jalinei/OWNVERTER/KiCAD_files/Feeder.kicad_sch

## KiCad design KiCAD_files/Feeder.kicad_sch (2024-07-15)

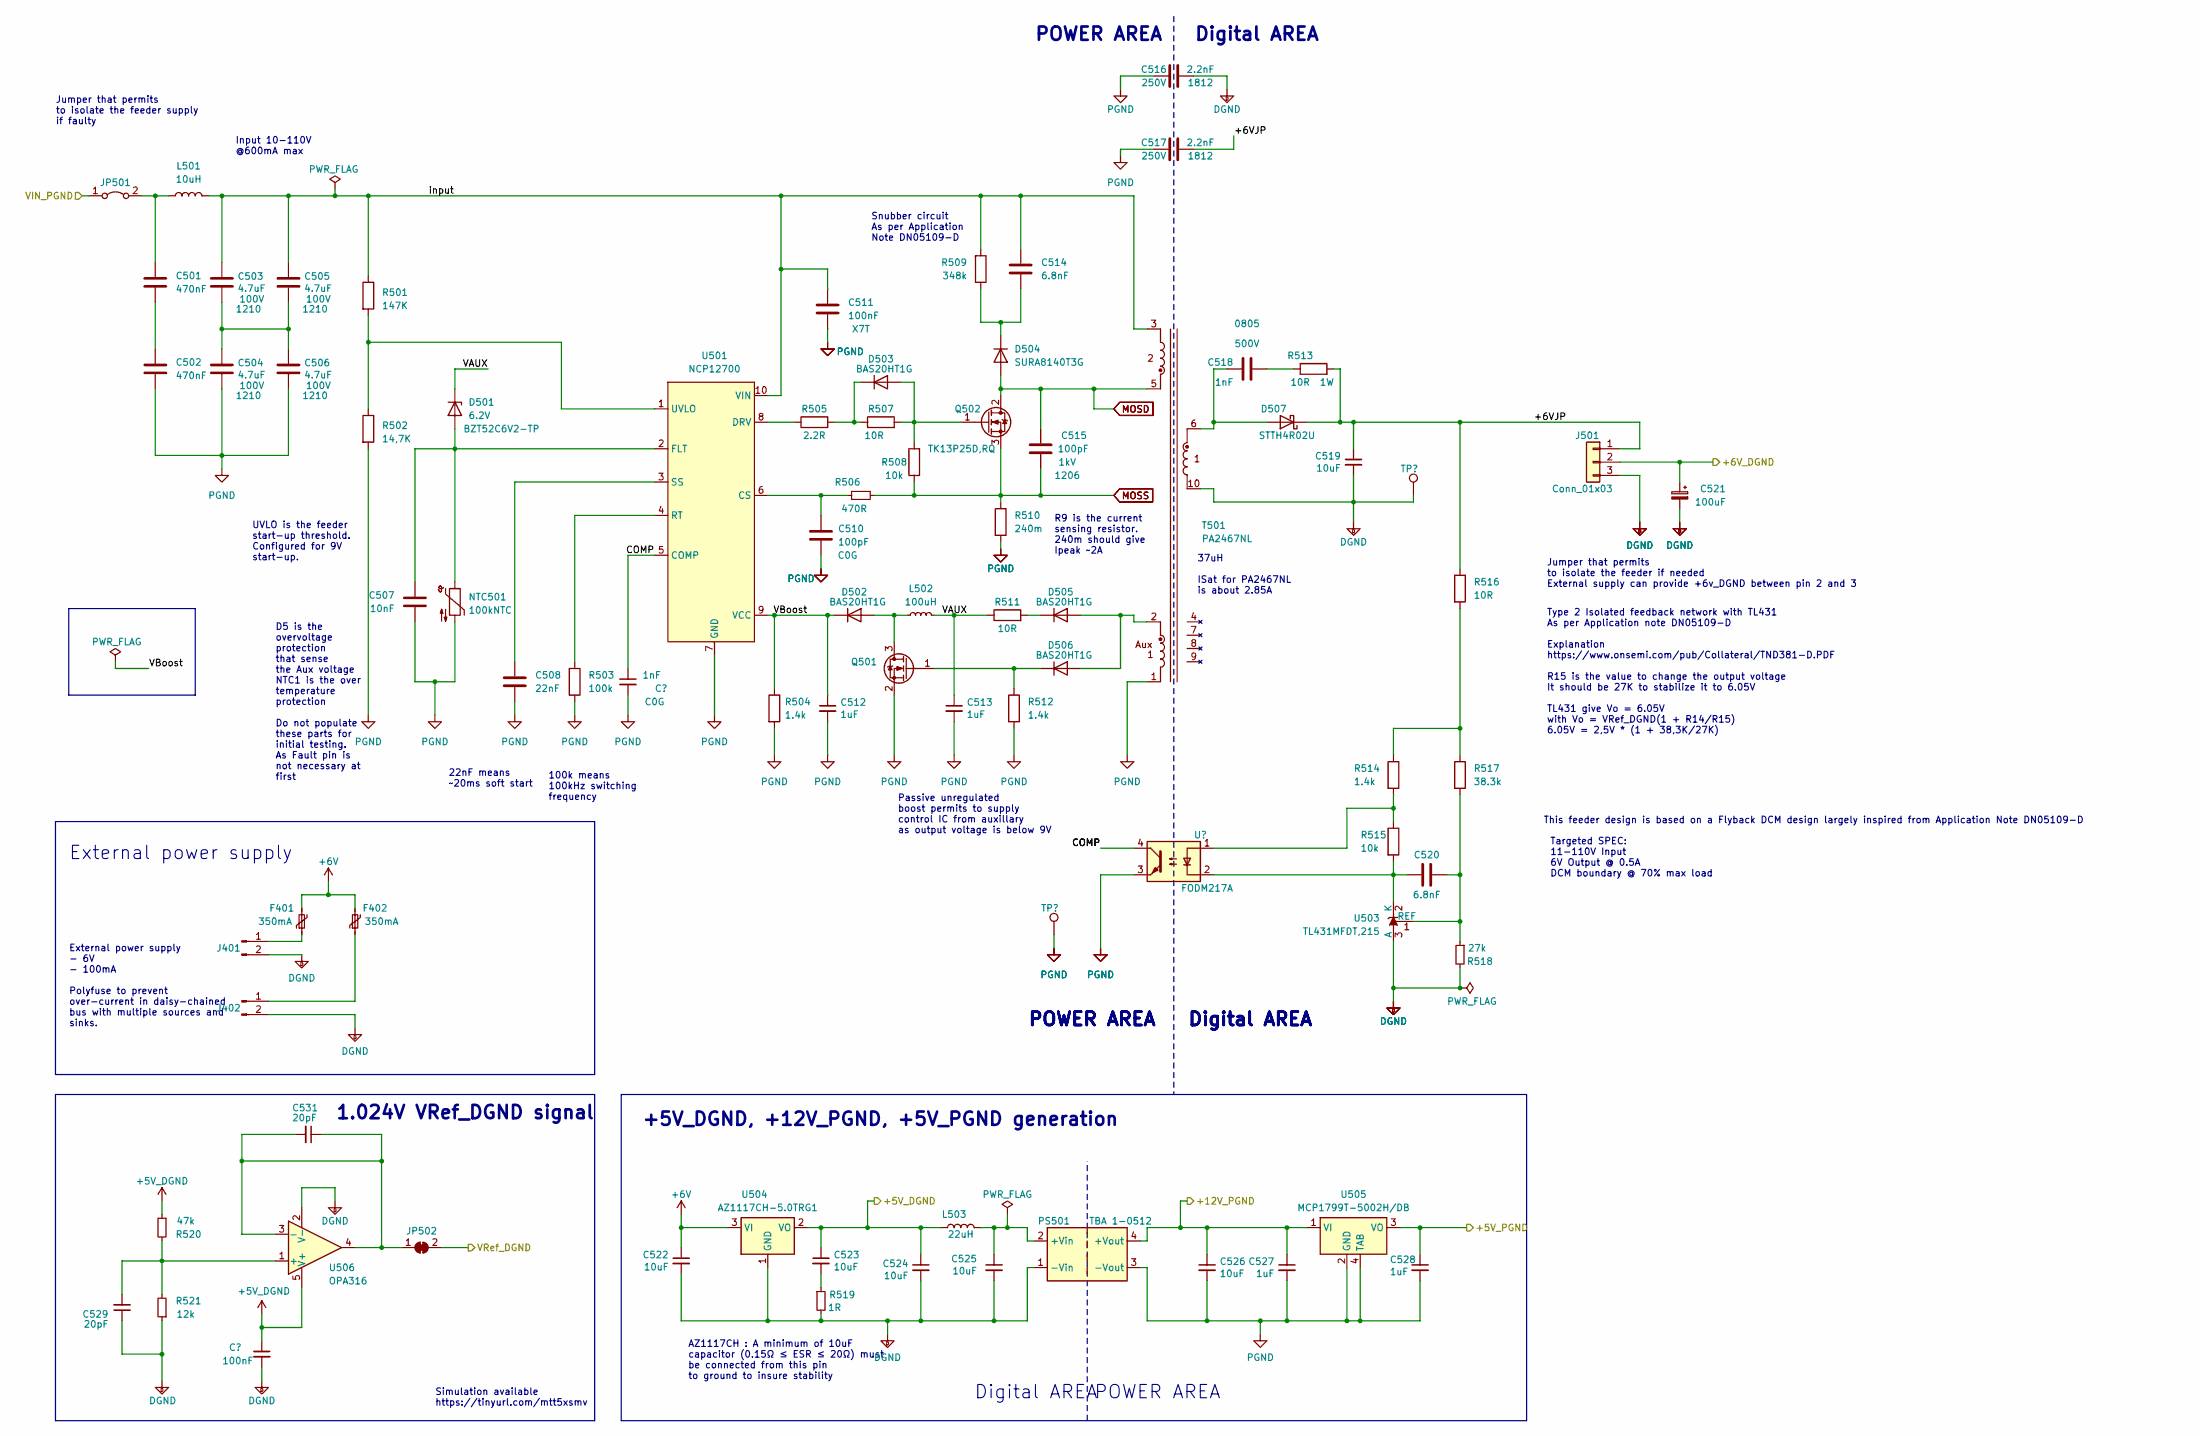
[picture p1: schematic Feeder.kicad_sch]

Parts:
C501, C502: 470nF; C_0805_2012Metric
C503, C504, C505, C506: 4.7uF; C_1210_3225Metric; Voltage 100V
C507: 10nF; C_0805_2012Metric
C508: 22nF; C_0805_2012Metric
C509: 1nF; C_0805_2012Metric; Voltage 100V
C510: 100pF; C_0805_2012Metric
C511: 100nF; C_0805_2012Metric
C512, C513, C527, C528: 1uF; C_0805_2012Metric
C514, C520: 6.8nF; C_0805_2012Metric
C515: 100pF; C_1206_3216Metric; Voltage 1kV
C516, C517: 2.2nF; C_1812_4532Metric; Voltage 250V
C518: 1nF; C_0805_2012Metric; Voltage 500V
C519, C522, C523: 10uF; C_1210_3225Metric; Voltage 50V
C521: 100uF; CP_Elec_6.3x7.7
C524, C525, C526: 10uF; C_1210_3225Metric; Voltage 25V
C529, C531: 20pF; C_0805_2012Metric
C530: 100nF; C_0805_2012Metric; Voltage 50V
D501: 6.2V; D_SOD-123
D502, D503, D505, D506: BAS20HT1G; D_SOD-323_HandSoldering
D504: SURA8140T3G; D_SMA
D507: STTH4R02U; D_SMB
F401, F402: 350mA; Fuse_1210_3225Metric
J401, J402: Conn_01x02_Male; JST_EH_B2B-EH-A_1x02_P2.50mm_Vertical
J501: Conn_01x03; PinHeader_1x03_P2.54mm_Vertical
JP501: Jumper_2_Bridged; SolderJumper-2_P1.3mm_Bridged2Bar_Pad1.0x1.5mm
JP502: SolderJumper_2_Open; SolderJumper-2_P1.3mm_Bridged_Pad1.0x1.5mm
L501: 10uH; L_1210_3225Metric
L502: 100uH; L_0805_2012Metric
L503: 22uH; L_1210_3225Metric
NTC501: 100kNTC; R_0805_2012Metric
PS501: TBA 1-0512; Converter_DCDC_Murata_MEE1SxxxxSC_THT
Q501: 60V N channel; SOT-23_copy
Q502: TK13P25D,RQ; TO-252-2
R501: 147K; R_0805_2012Metric
R502: 14,7K; R_0805_2012Metric
R503: 100k; R_0805_2012Metric
R504, R512, R514: 1.4k; R_0805_2012Metric
R505: 2.2R; R_0805_2012Metric
R506: 470R; R_0805_2012Metric
R507, R511, R516: 10R; R_0805_2012Metric
R508, R515: 10k; R_0805_2012Metric
R509: 348k; R_0805_2012Metric
R510: 240m; R_1210_3225Metric
R513: 10R; R_2010_5025Metric
R517: 38.3k; R_0805_2012Metric
R518: 27k; R_0805_2012Metric
R519: 1R; R_0805_2012Metric
R520: 47k; R_0805_2012Metric
R521: 12k; R_0805_2012Metric
T501: PA2467NL
TP501, TP502: TestPoint; TestPoint_THTPad_D1.5mm_Drill0.7mm
U501: NCP12700; MSOP-10_3x3mm_P0.5mm
U502: FODM217A; SO-4_4.4x2.3mm_P1.27mm
U503: TL431MFDT,215; SOT-23
U504: AZ1117CH-5.0TRG1; SOT-223-3_TabPin2
U505: MCP1799T-5002H/DB; SOT-223
U506: OPA316; SOT-353_SC-70-5_Handsoldering

Connections:
+5V_DGND: C523.1, C524.1, C530.1, L503.1, R520.1, U504.2 (VO), U506.5 (V+)
+5V_PGND: C528.1, U505.3 (VO)
+6V: C522.1, F401.2, F402.2, U504.3 (VI)
+6VJP: C517.2, C519.1, D507.1 (K), J501.1, R513.2, R516.1
+6V_DGND: C521.1, J501.2
+12V_PGND: C526.1, C527.1, PS501.4 (+Vout), U505.1 (VI)
COMP: C509.1, U501.5 (COMP), U502.4
DGND: C516.2, C519.2, C521.2, C522.2, C524.2, C525.2, C529.1, C530.2, J401.2, J402.2, J501.3, PS501.1 (-Vin), R518.2, R519.2, R521.1, T501.10, TP502.1, U503.3 (A), U504.1 (GND), U506.2 (V-)
MOSD: C515.1, D504.2 (A), Q502.2 (D), T501.5
MOSS: C515.2, Q502.3 (S), R506.2, R508.1, R510.1
unnamed: C501.1, JP501.2 (B), L501.1
unnamed: C501.2, C502.1
unnamed: C503.2, C504.1, C505.2, C506.1
unnamed: C507.2, D501.2 (A), NTC501.1, U501.2 (FLT)
unnamed: C508.1, U501.3 (SS)
unnamed: C510.1, R506.1, U501.6 (CS)
unnamed: C514.2, D504.1 (K), R509.1
unnamed: C518.1, D507.2 (A), T501.6
unnamed: C518.2, R513.1
unnamed: C520.1, R515.2, U502.2, U503.2 (K)
unnamed: C520.2, R517.2, R518.1, U503.1 (REF)
unnamed: C523.2, R519.1
unnamed: C525.1, L503.2, PS501.2 (+Vin)
unnamed: C529.2, R520.2, R521.2, U506.1 (+)
unnamed: C531.1, C531.2, JP502.1 (A), U506.3 (-), U506.4
unnamed: D502.2 (A), L502.1, Q501.3 (D)
unnamed: D503.1 (K), R505.2, R507.1
unnamed: D503.2 (A), Q502.1 (G), R507.2, R508.2
unnamed: D505.1 (K), R511.2
unnamed: D505.2 (A), D506.2 (A), T501.2
unnamed: D506.1 (K), Q501.1 (G), R512.1
unnamed: F401.1, J401.1
unnamed: F402.1, J402.1
unnamed: R501.2, R502.1, U501.1 (UVLO)
unnamed: R503.1, U501.4 (RT)
unnamed: R505.1, U501.8 (DRV)
unnamed: R514.1, R516.2, R517.1
unnamed: R514.2, R515.1, U502.1
PGND: C502.2, C504.2, C506.2, C507.1, C508.2, C509.2, C510.2, C511.2, C512.2, C513.2, C516.1, C517.1, C526.2, C527.2, C528.2, NTC501.2, PS501.3 (-Vout), Q501.2 (S), R502.2, R503.2, R504.2, R510.2, R512.2, T501.1, TP501.1, U501.7 (GND), U502.3, U505.2 (GND), U505.4 (TAB)
VAUX: C513.1, D501.1 (K), L502.2, R511.1
VBoost: C512.1, D502.1 (K), R504.1, U501.9 (VCC)
VIN_PGND: JP501.1 (A)
VRef_DGND: JP502.2 (B)
input: C503.1, C505.1, C511.1, C514.1, L501.2, R501.1, R509.2, T501.3, U501.10 (VIN)

Notes on the sheet:
Snubber circuit As per Application Note DN05109-D
Input 10-110V @600mA max
R9 is the current sensing resistor. 240m should give Ipeak ~2A
POWER AREA
Digital AREA
Jumper that permits to isolate the feeder if needed External supply can provide +6v_DGND between pin 2 and 3
Targeted SPEC: 11-110V Input 6V Output @ 0.5A DCM boundary @ 70% max load
UVLO is the feeder start-up threshold. Configured for 9V start-up.
AZ1117CH : A minimum of 10uF capacitor (0.15Ω ≤ ESR ≤ 20Ω) must be connected from this pin to ground to insure stability
D5 is the overvoltage protection that sense the Aux voltage NTC1 is the over temperature protection Do not populate these parts for initial testing. As Fault pin is not necessary at first
External power supply - 6V - 100mA Polyfuse to prevent over-current in daisy-chained bus with multiple sources and sinks.
Passive unregulated boost permits to supply control IC from auxillary as output voltage is below 9V
Jumper that permits to isolate the feeder supply if faulty
This feeder design is based on a Flyback DCM design largely inspired from Application Note DN05109-D
100k means 100kHz switching frequency
37uH ISat for PA2467NL is about 2.85A
External power supply
1.024V VRef_DGND signal
22nF means ~20ms soft start
Simulation available https://tinyurl.com/mtt5xsmv
+5V_DGND, +12V_PGND, +5V_PGND generation
Type 2 Isolated feedback network with TL431 As per Application note DN05109-D Explanation https://www.onsemi.com/pub/Collateral/TND381-D.PDF R15 is the value to change the output voltage It should be 27K to stabilize it to 6.05V TL431 give Vo = 6.05V with Vo = VRef_DGND(1 + R14/R15) 6.05V = 2,5V * 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
