jalinei/OWNVERTER/KiCAD_files/Hall_Sensor.kicad_sch

## KiCad design KiCAD_files/Hall_Sensor.kicad_sch (2024-07-15)

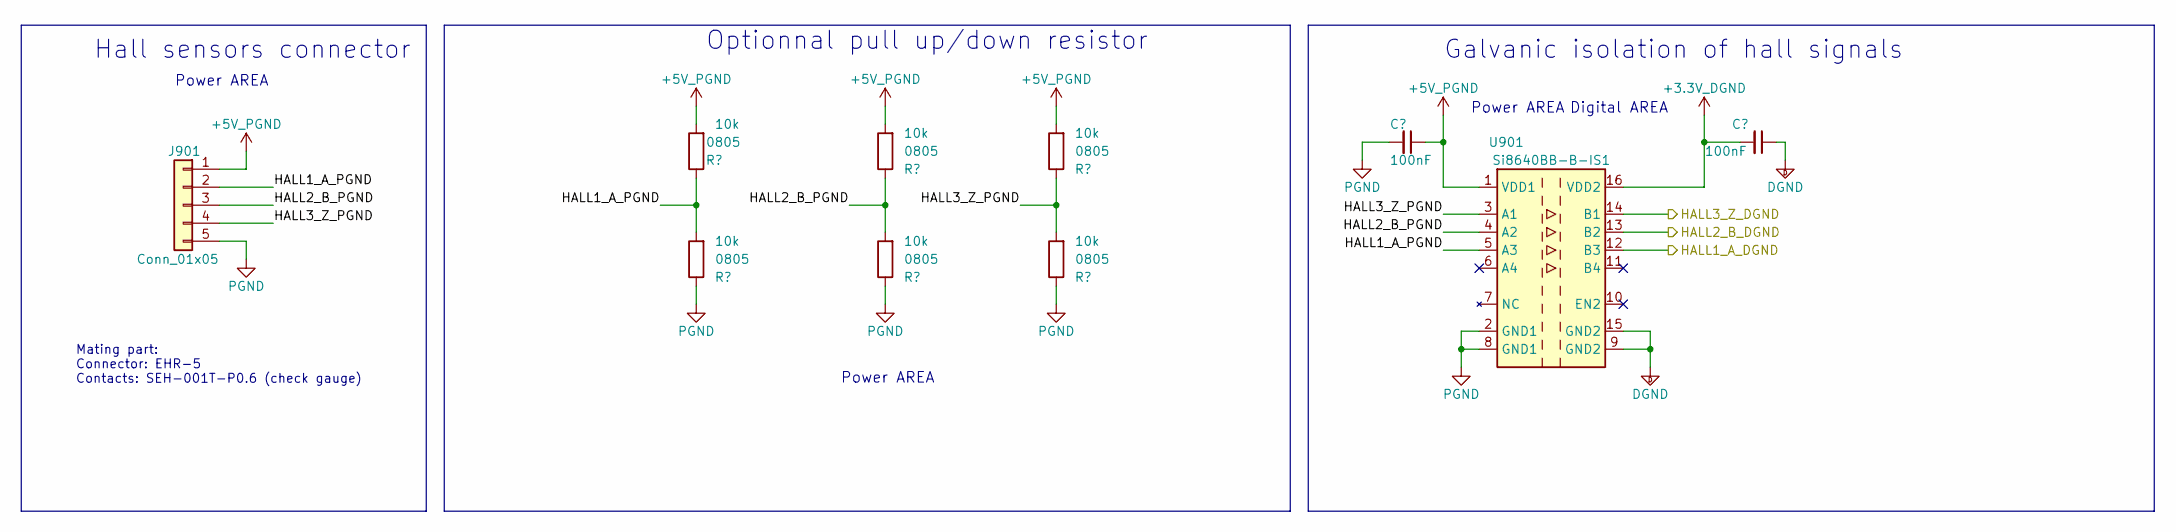
[picture p2: schematic Hall_Sensor.kicad_sch]

Parts:
C901, C902: 100nF; C_0805_2012Metric; Voltage 50V
J901: Conn_01x05; JST_EH_B5B-EH-A_1x05_P2.50mm_Vertical
R901, R902, R903, R904, R905, R906: 10k; R_0805_2012Metric
U901: Si8640BB-B-IS1; SOIC-16_3.9x9.9mm_P1.27mm

Connections:
+3.3V_DGND: C902.2, U901.16 (VDD2)
+5V_PGND: C901.1, J901.1, R901.2, R903.2, R905.2, U901.1 (VDD1)
DGND: C902.1, U901.9 (GND2), U901.15 (GND2)
HALL1_A_DGND: U901.12 (B3)
HALL1_A_PGND: J901.2, R901.1, R902.2, U901.5 (A3)
HALL2_B_DGND: U901.13 (B2)
HALL2_B_PGND: J901.3, R903.1, R904.2, U901.4 (A2)
HALL3_Z_DGND: U901.14 (B1)
HALL3_Z_PGND: J901.4, R905.1, R906.2, U901.3 (A1)
PGND: C901.2, J901.5, R902.1, R904.1, R906.1, U901.2 (GND1), U901.8 (GND1)

Notes on the sheet:
Hall sensors connector
Galvanic isolation of hall signals
Digital AREA
Power AREA
Optionnal pull up/down resistor
Mating part: Connector: EHR-5 Contacts: SEH-001T-P0.6 (check gauge)
