jalinei/OWNVERTER/KiCAD_files/High_side.kicad_sch

## KiCad design KiCAD_files/High_side.kicad_sch (2024-07-15)

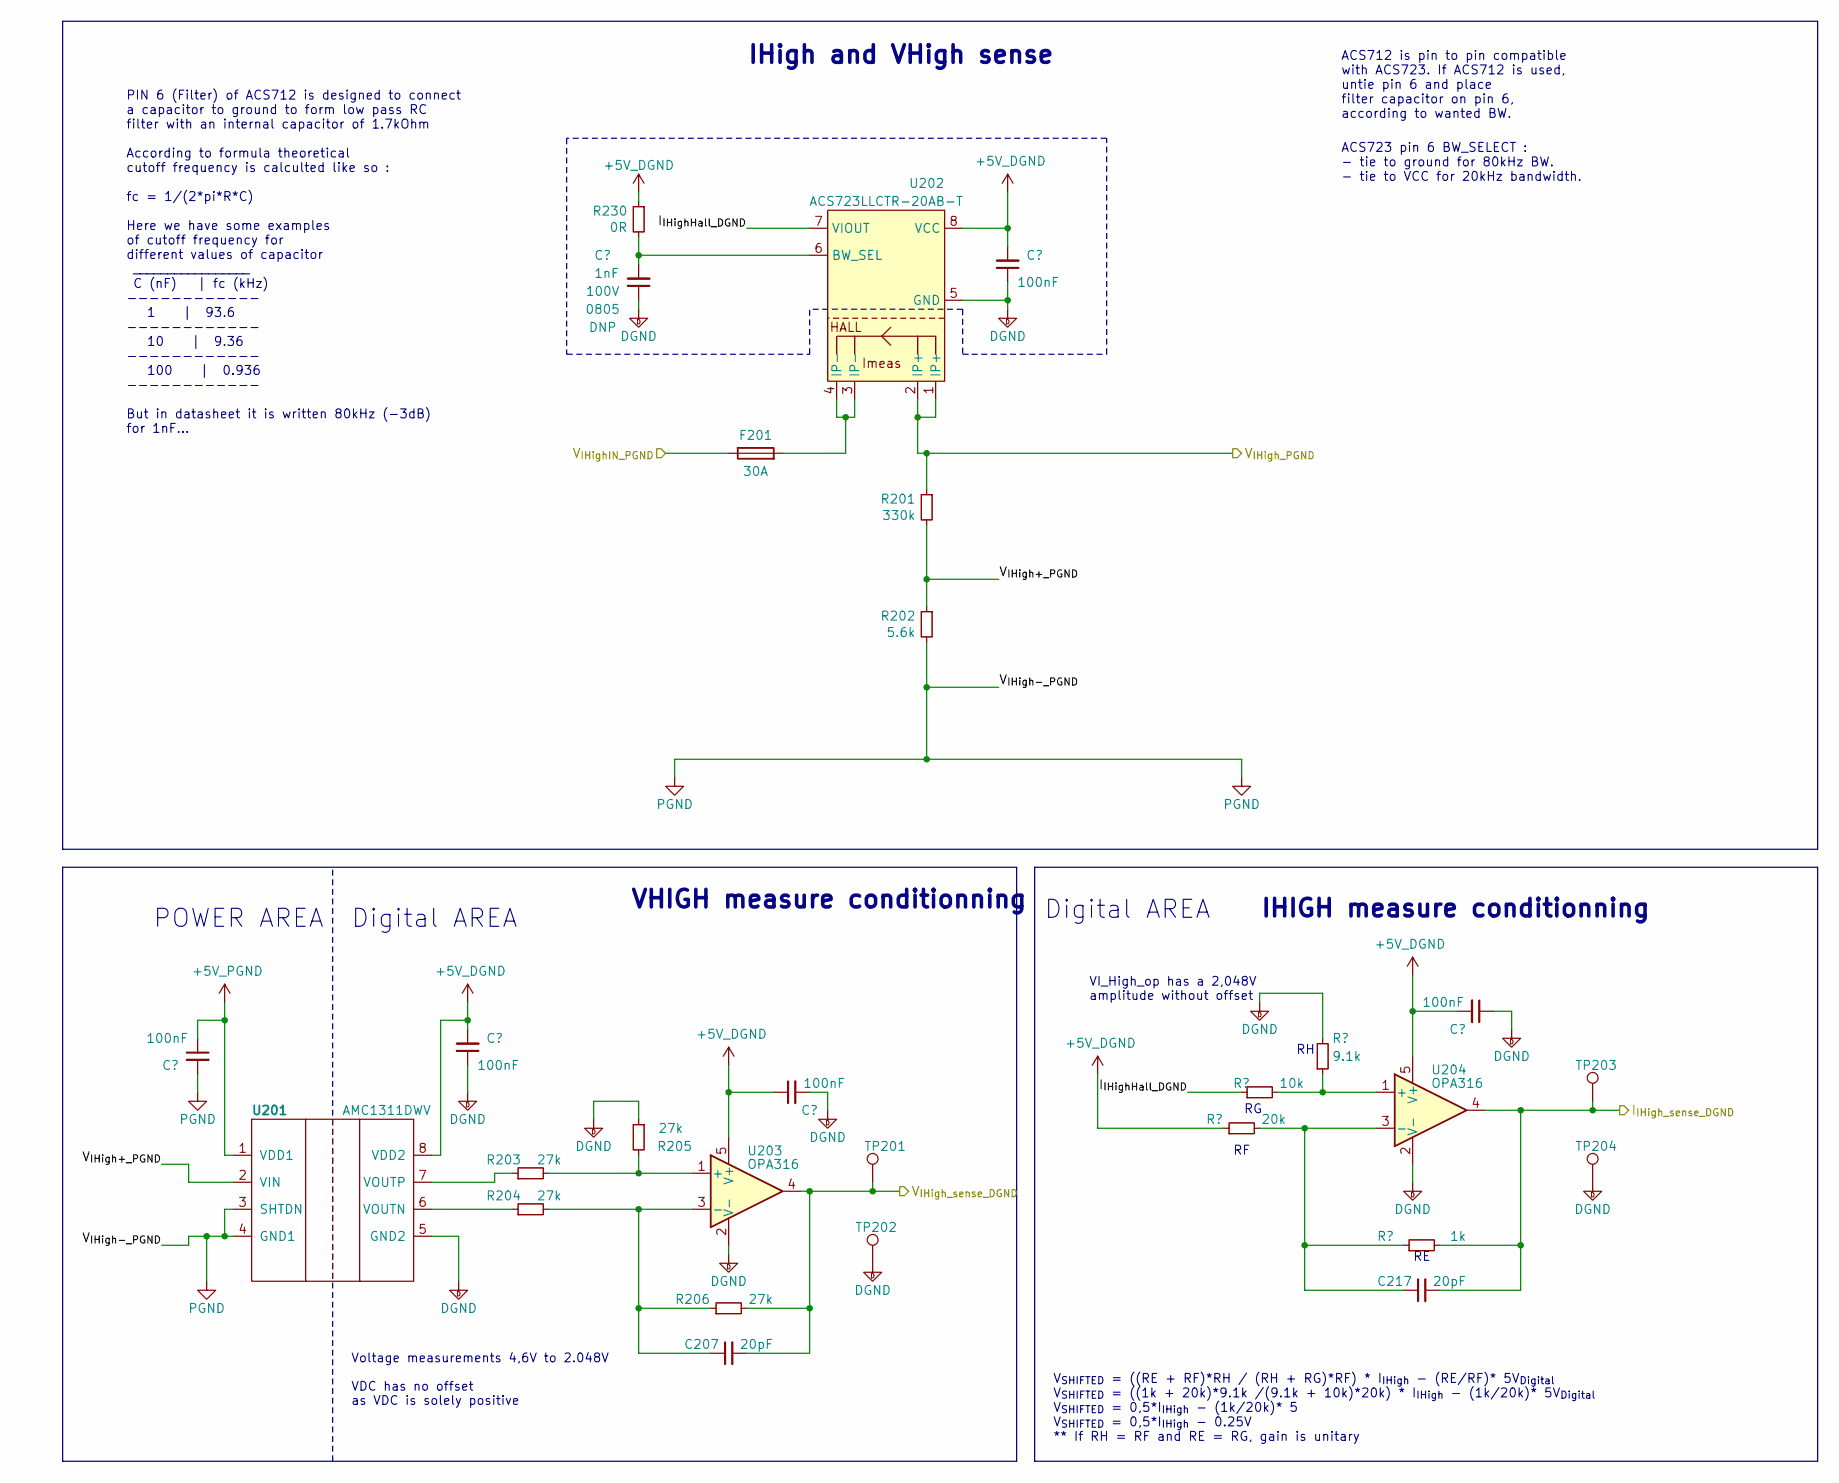
[picture p3: schematic High_side.kicad_sch]

Parts:
C201, C202, C203, C209, C218: 100nF; C_0805_2012Metric; Voltage 50V
C204: 1nF; C_0805_2012Metric; Voltage 100V
C207, C217: 20pF; C_0805_2012Metric
F201: 30A; F_0678H_Bel
R201: 330k; R_0805_2012Metric
R202: 5.6k; R_0805_2012Metric
R203, R204, R205, R206: 27k; R_0805_2012Metric
R209: 10k; R_0805_2012Metric
R210: 20k; R_0805_2012Metric
R211: 9.1k; R_0805_2012Metric
R212: 1k; R_0805_2012Metric
R230: 0R; R_0805_2012Metric
TP201, TP202, TP203, TP204: TestPoint; TestPoint_THTPad_D1.5mm_Drill0.7mm
U201: AMC1311DWV; SOIC-8_7.5x5.85mm_P1.27mm
U202: ACS723LLCTR-20AB-T; SOIC-8_3.9x4.9mm_P1.27mm
U203, U204: OPA316; SOT-353_SC-70-5_Handsoldering

Connections:
+5V_DGND: C202.2, C203.2, C209.1, C218.2, R210.1, R230.1, U201.8 (VDD2), U202.8 (VCC), U203.5 (V+), U204.5 (V+)
+5V_PGND: C201.1, U201.1 (VDD1)
DGND: C202.1, C203.1, C204.1, C209.2, C218.1, R205.1, R211.2, TP202.1, TP204.1, U201.5 (GND2), U202.5 (GND), U203.2 (V-), U204.2 (V-)
I_{IHighHall_DGND}: R209.1, U202.7 (VIOUT)
I_{IHigh_sense_DGND}: C217.2, R212.2, TP203.1, U204.4
unnamed: C204.2, R230.2, U202.6 (BW_SEL)
unnamed: C207.1, R204.2, R206.1, U203.3 (-)
unnamed: C217.1, R210.2, R212.1, U204.3 (-)
unnamed: F201.2, U202.3 (IP-), U202.4 (IP-)
unnamed: R203.1, U201.7 (VOUTP)
unnamed: R203.2, R205.2, U203.1 (+)
unnamed: R204.1, U201.6 (VOUTN)
unnamed: R209.2, R211.1, U204.1 (+)
PGND: C201.2, R202.2, U201.3 (SHTDN), U201.4 (GND1)
V_{IHigh+_PGND}: R201.2, R202.1, U201.2 (VIN)
V_{IHighIN_PGND}: F201.1
V_{IHigh_PGND}: R201.1, U202.1 (IP+), U202.2 (IP+)
V_{IHigh_sense_DGND}: C207.2, R206.2, TP201.1, U203.4

Notes on the sheet:
Digital AREA
IHIGH measure conditionning
IHigh and VHigh sense
POWER AREA
PIN 6 (Filter) of ACS712 is designed to connect a capacitor to ground to form low pass RC filter with an internal capacitor of 1.7kOhm According to formula theoretical cutoff frequency is calculted like so : fc = 1/(2*pi*R*C) Here we have some examples of cutoff frequency for different values of ca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
ACS723 pin 6 BW_SELECT : - tie to ground for 80kHz BW. - tie to VCC for 20kHz bandwidth.
VI_High_op has a 2,048V amplitude without offset
Voltage measurements 4,6V to 2.048V VDC has no offset as VDC is solely positive
V_{SHIFTED} = ((RE + RF)*RH / (RH + RG)*RF) * I_{IHigh} - (RE/RF)* 5V_{Digital} V_{SHIFTED} = ((1k + 20k)*9.1k /(9.1k + 10k)*20k) * I_{IHigh} - (1k/20k)* 5V_{Digital} V_{SHIFTED} = 0,5*I_{IHigh} - (1k/20k)* 5 V_{SHIFTED} = 0,5*I_{IHigh} - 0.25V ** If RH = RF and RE = RG, gain is unitary
VHIGH measure conditionning
ACS712 is pin to pin compatible with ACS723. If ACS712 is used, untie pin 6 and place filter capacitor on pin 6, according to wanted BW.
