jalinei/OWNVERTER/KiCAD_files/InverterLeg.kicad_sch

## KiCad design KiCAD_files/InverterLeg.kicad_sch (2024-07-15)

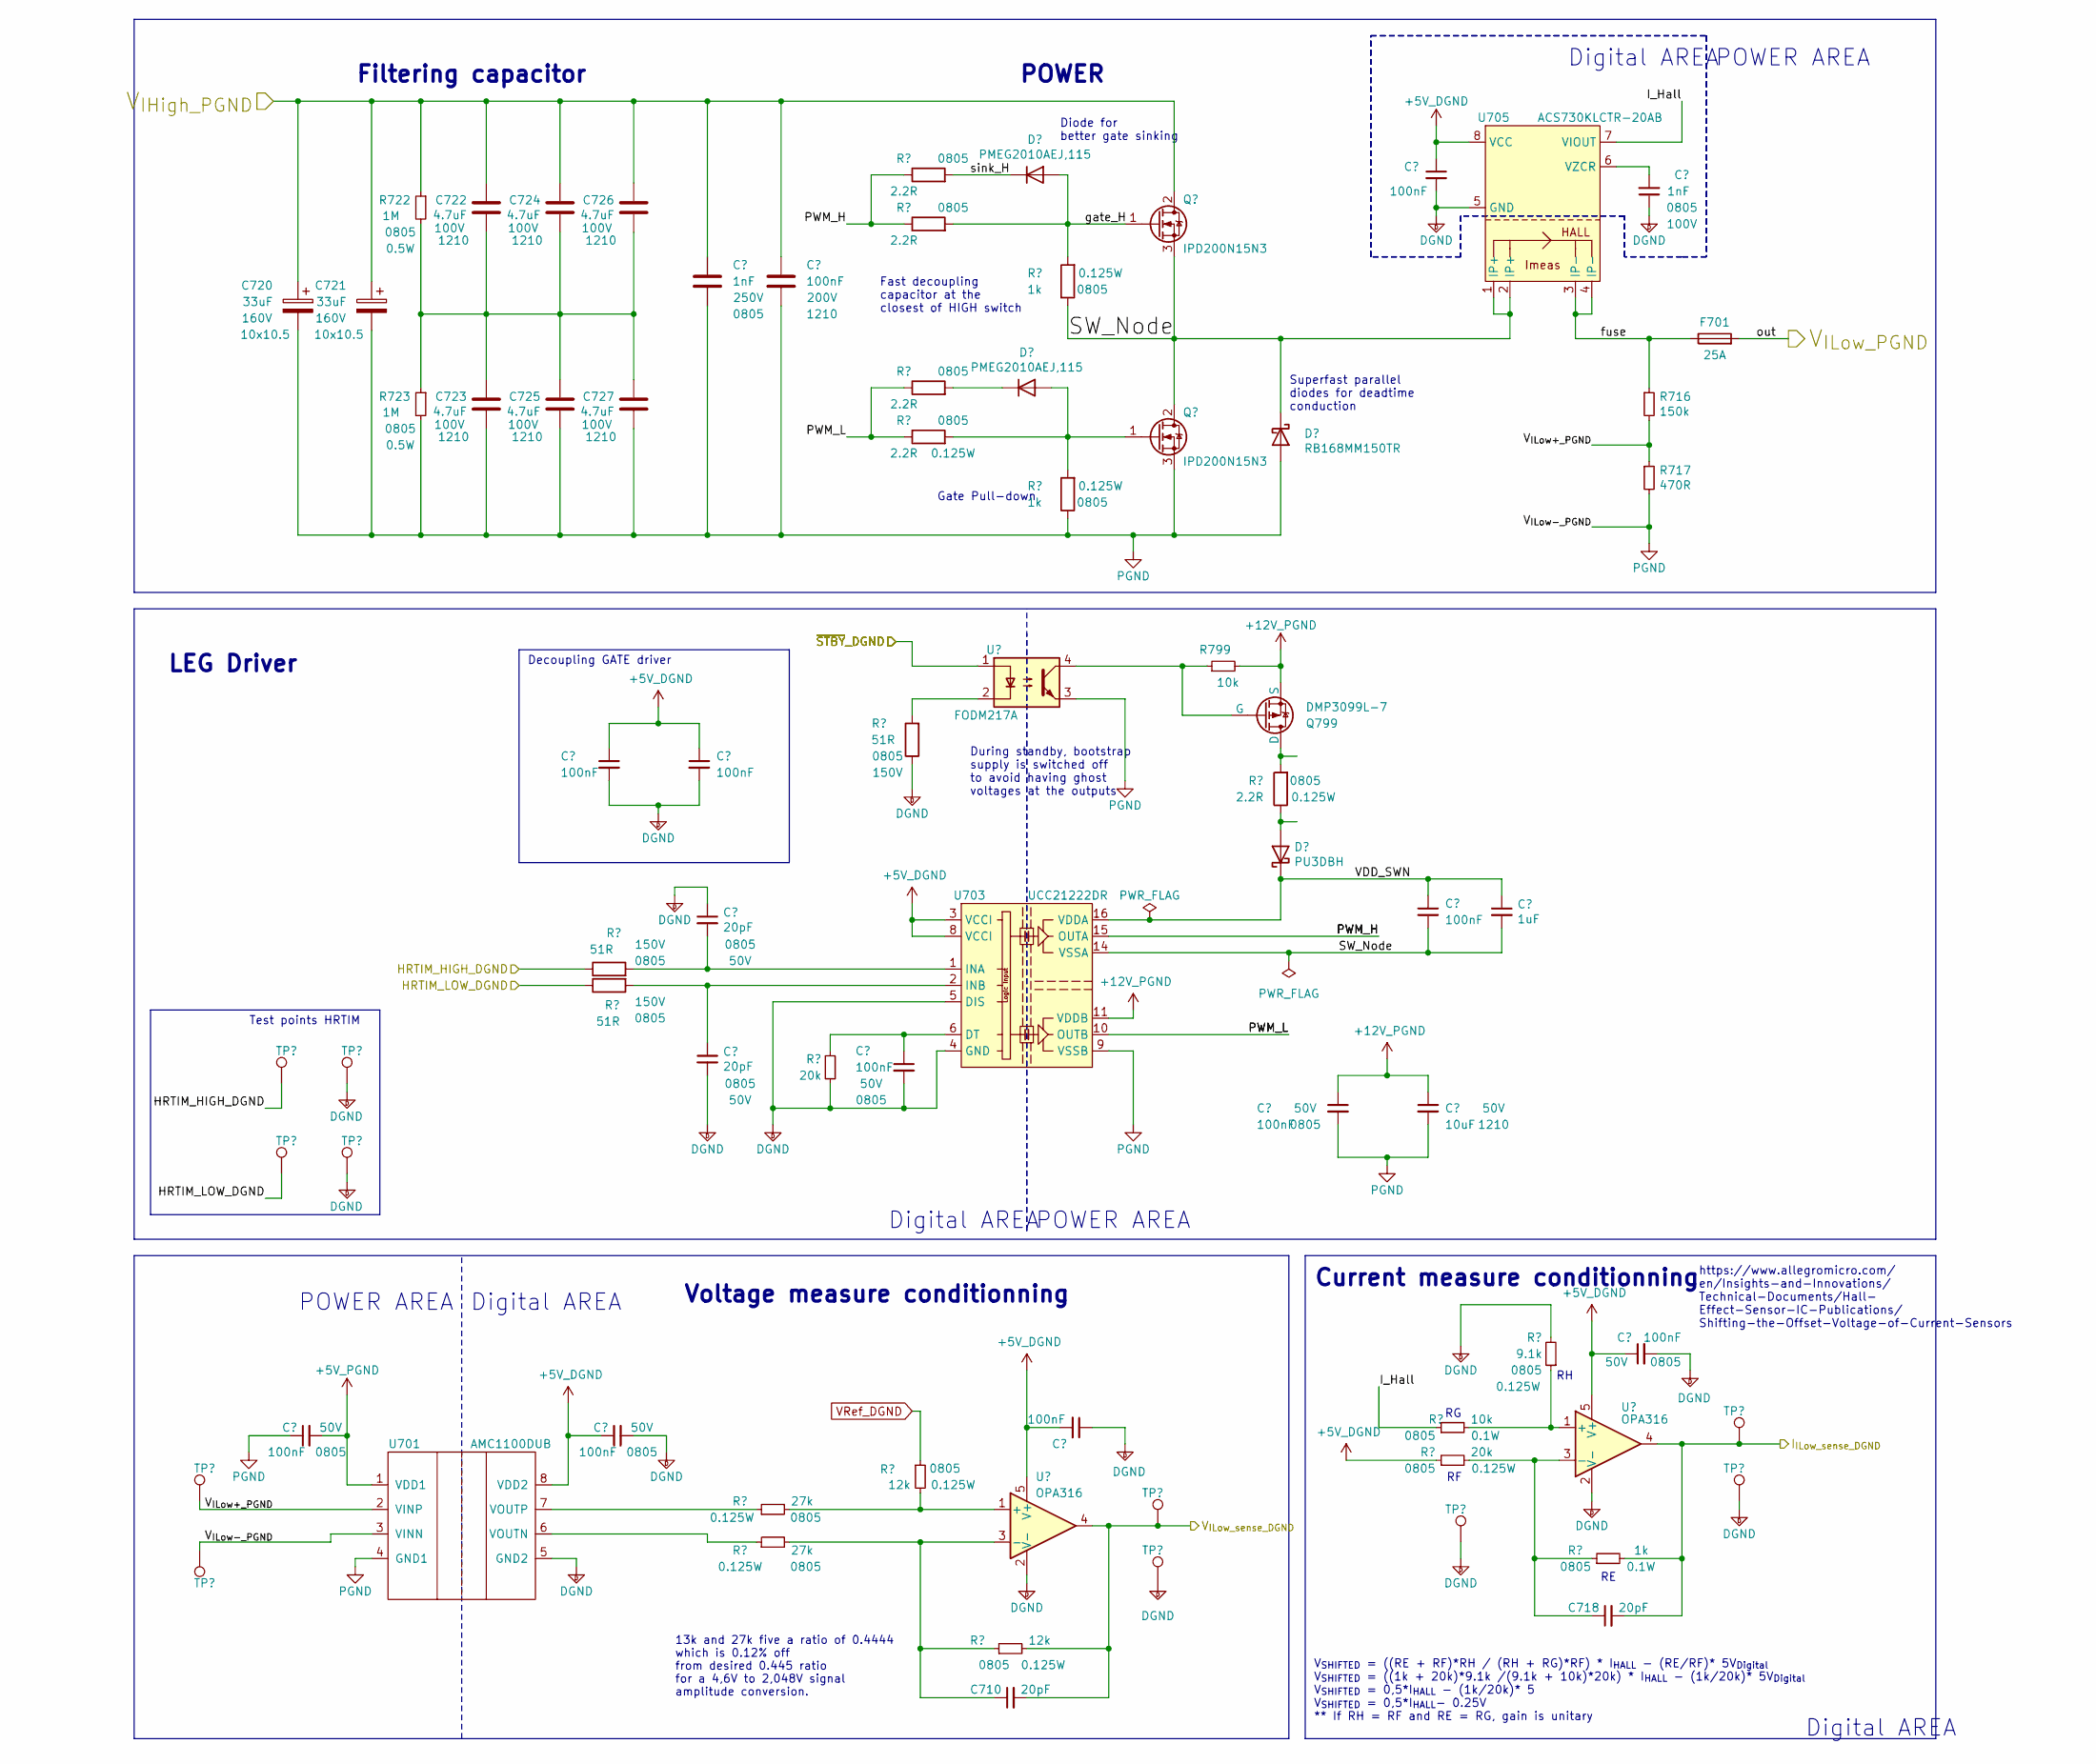
[picture p4: schematic InverterLeg.kicad_sch]

Parts:
C701, C702, C705, C706, C707, C711, C712, C713, C714, C719: 100nF; C_0805_2012Metric; Voltage 50V
C703, C704: 20pF; C_0805_2012Metric; Voltage 50V
C708: 1nF; C_0805_2012Metric; Voltage 250V
C709: 100nF; C_1210_3225Metric; Voltage 200V
C710, C718: 20pF; C_0805_2012Metric
C715: 1uF; C_0805_2012Metric; Voltage 50V
C716: 10uF; C_1210_3225Metric; Voltage 50V
C717: 1nF; C_0805_2012Metric; Voltage 100V
C720, C721: 33uF; CP_Elec_10x10.5; Voltage 160V
C722, C723, C724, C725, C726, C727: 4.7uF; C_1210_3225Metric; Voltage 100V
D701, D702: PMEG2010AEJ,115; D_SOD-323_HandSoldering
D704: RB168MM150TR; D_SOD-123
D705: PU3DBH; D_SMB
F701: 25A; F_0678H_Bel
Q701, Q702: IPD200N15N3; TO-252-2
Q799: DMP3099L-7; SOT-23
R701, R702, R703, R704, R714: 2.2R; R_0805_2012Metric
R705, R706, R710: 51R; R_0805_2012Metric; Voltage 150V
R707, R708, R721: 1k; R_0805_2012Metric
R709, R719: 20k; R_0805_2012Metric
R711, R712: 27k; R_0805_2012Metric
R713, R715: 12k; R_0805_2012Metric
R716: 150k; R_0805_2012Metric
R717: 470R; R_0805_2012Metric
R718, R799: 10k; R_0805_2012Metric
R720: 9.1k; R_0805_2012Metric
R722, R723: 1M; R_0805_2012Metric
TP701, TP702, TP703, TP712, TP713, TP716, TP717: TestPoint; TestPoint_THTPad_D1.5mm_Drill0.7mm
TP704, TP705, TP706, TP707: TestPoint; TestPoint_Pad_D1.0mm
U701: AMC1100DUB; SOP-8_6.62x9.15mm_P2.54mm
U702: FODM217A; SO-4_4.4x2.3mm_P1.27mm
U703: UCC21222DR; SOIC-16_3.9x9.9mm_P1.27mm
U704, U706: OPA316; SOT-353_SC-70-5_Handsoldering
U705: ACS730KLCTR-20AB; SOIC-8_3.9x4.9mm_P1.27mm

Connections:
+5V_DGND: C702.1, C705.1, C706.1, C711.1, C713.2, C719.1, R719.1, U701.8 (VDD2), U703.3 (VCCI), U703.8 (VCCI), U704.5 (V+), U705.8 (VCC), U706.5 (V+)
+5V_PGND: C701.2, U701.1 (VDD1)
+12V_PGND: C714.1, C716.1, Q799.3 (S), R799.2, U703.11 (VDDB)
DGND: C702.2, C703.1, C704.2, C705.2, C706.2, C707.2, C711.2, C713.1, C717.1, C719.2, R709.1, R710.1, R720.2, TP703.1, TP706.1, TP707.1, TP713.1, TP717.1, U701.5 (GND2), U703.4 (GND), U703.5 (DIS), U704.2 (V-), U705.5 (GND), U706.2 (V-)
HRTIM_HIGH_DGND: R705.1, TP704.1
HRTIM_LOW_DGND: R706.1, TP705.1
I_Hall: R718.1, U705.7 (VIOUT)
I_{ILow_sense_DGND}: C718.2, R721.2, TP716.1, U706.4
unnamed: C703.2, R705.2, U703.1 (INA)
unnamed: C704.1, R706.2, U703.2 (INB)
unnamed: C707.1, R709.2, U703.6 (DT)
unnamed: C710.1, R712.2, R715.1, U704.3 (-)
unnamed: C717.2, U705.6 (VZCR)
unnamed: C718.1, R719.2, R721.1, U706.3 (-)
unnamed: C722.2, C723.1, C724.2, C725.1, C726.2, C727.1, R722.2, R723.1
unnamed: D701.1 (K), R703.2
unnamed: D701.2 (A), Q702.1 (G), R704.2, R708.2
unnamed: D705.2 (A), R714.1
unnamed: Q799.1 (D), R714.2
unnamed: Q799.2 (G), R799.1, U702.4
unnamed: R710.2, U702.2
unnamed: R711.1, U701.7 (VOUTP)
unnamed: R711.2, R713.2, U704.1 (+)
unnamed: R712.1, U701.6 (VOUTN)
unnamed: R718.2, R720.1, U706.1 (+)
PGND: C701.1, C708.2, C709.2, C714.2, C716.2, C720.2, C721.2, C723.2, C725.2, C727.2, D704.2 (A), Q702.3 (S), R708.1, R717.2, R723.2, TP702.1, U701.3 (VINN), U701.4 (GND1), U702.3, U703.9 (VSSB)
PWM_H: R701.1, R702.1, U703.15 (OUTA)
PWM_L: R703.1, R704.1, U703.10 (OUTB)
SW_Node: C712.2, C715.2, D704.1 (K), Q701.3 (S), Q702.2 (D), R707.1, U703.14 (VSSA), U705.1 (IP+), U705.2 (IP+)
VDD_SWN: C712.1, C715.1, D705.1 (K), U703.16 (VDDA)
VRef_DGND: R713.1
V_{IHigh_PGND}: C708.1, C709.1, C720.1, C721.1, C722.1, C724.1, C726.1, Q701.2 (D), R722.1
V_{ILow+_PGND}: R716.2, R717.1, TP701.1, U701.2 (VINP)
V_{ILow_sense_DGND}: C710.2, R715.2, TP712.1, U704.4
fuse: F701.1, R716.1, U705.3 (IP-), U705.4 (IP-)
gate_H: D702.2 (A), Q701.1 (G), R702.2, R707.2
out: F701.2
sink_H: D702.1 (K), R701.2
~STBY_DGND: U702.1

Notes on the sheet:
Filtering capacitor
https://www.allegromicro.com/ en/Insights-and-Innovations/ Technical-Documents/Hall- Effect-Sensor-IC-Publications/ Shifting-the-Offset-Voltage-of-Current-Sensors
LEG Driver
Digital AREA
POWER AREA
Diode for better gate sinking
Test points HRTIM
POWER
Current measure conditionning
Voltage measure conditionning
During standby, bootstrap supply is switched off to avoid having ghost voltages at the outputs
13k and 27k five a ratio of 0.4444 which is 0.12% off from desired 0.445 ratio for a 4,6V to 2,048V signal amplitude conversion.
Gate Pull-down
V_{SHIFTED} = ((RE + RF)*RH / (RH + RG)*RF) * I_{HALL} - (RE/RF)* 5V_{Digital} V_{SHIFTED} = ((1k + 20k)*9.1k /(9.1k + 10k)*20k) * I_{HALL} - (1k/20k)* 5V_{Digital} V_{SHIFTED} = 0,5*I_{HALL} - (1k/20k)* 5 V_{SHIFTED} = 0,5*I_{HALL}- 0.25V ** If RH = RF and RE = RG, gain is unitary
Superfast parallel diodes for deadtime conduction
Decoupling GATE driver
Fast decoupling capacitor at the closest of HIGH switch
