jalinei/OWNVERTER/KiCAD_files/Microcontroller.kicad_sch

## KiCad design KiCAD_files/Microcontroller.kicad_sch (2024-07-15)

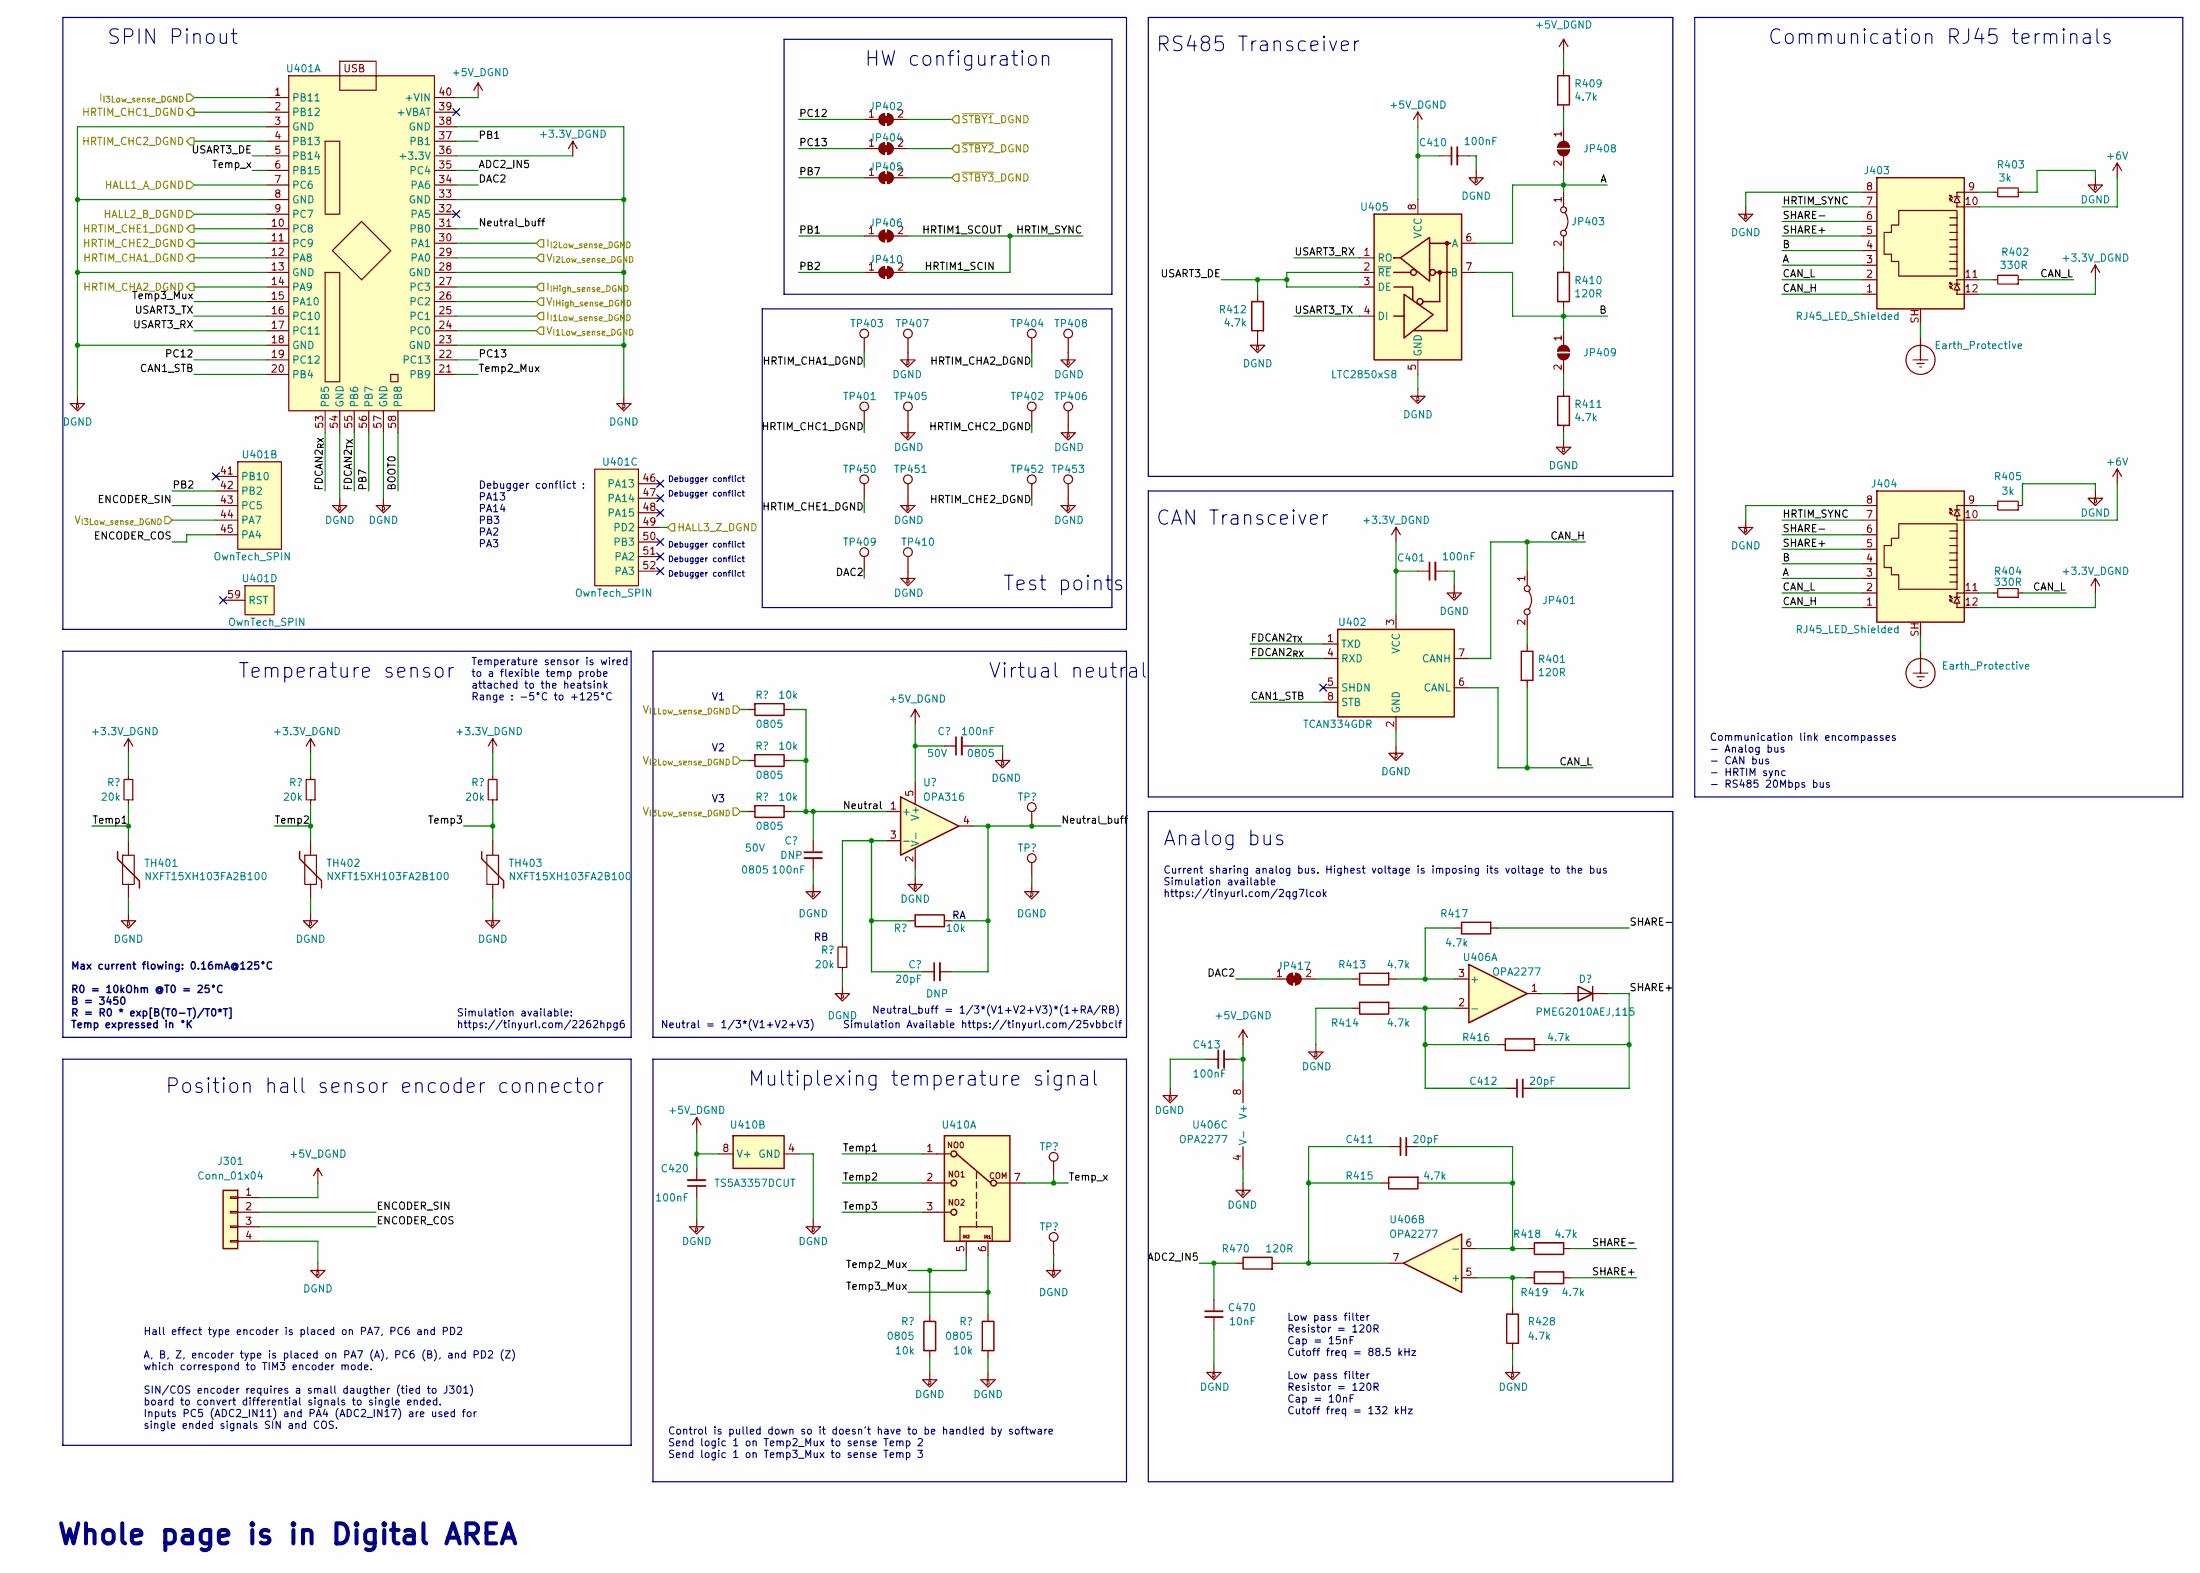
[picture p5: schematic Microcontroller.kicad_sch]

Parts:
C301: 20pF; C_0805_2012Metric; Voltage 50V
C401, C410, C413, C420: 100nF; C_0805_2012Metric
C411, C412: 20pF; C_0805_2012Metric
C470: 10nF; C_0805_2012Metric
C490, C491: 100nF; C_0805_2012Metric; Voltage 50V
D403: PMEG2010AEJ,115; D_SOD-323_HandSoldering
J301: Conn_01x04; JST_EH_B4B-EH-A_1x04_P2.50mm_Vertical
J403, J404: RJ45_LED_Shielded; ethernet_RJE721881411
JP401, JP403: Jumper; PinHeader_1x02_P2.54mm_Vertical
JP402, JP404, JP405, JP406, JP410, JP417: Jumper_2_Bridged; SolderJumper-2_P1.3mm_Bridged_Pad1.0x1.5mm
JP408, JP409: Jumper_2_Bridged; SolderJumper-2_P1.3mm_Open_Pad1.0x1.5mm
R401, R410, R470: 120R; R_0805_2012Metric
R402, R404: 330R; R_0805_2012Metric
R403, R405: 3k; R_0805_2012Metric
R406, R407, R450, R494: 20k; R_0805_2012Metric
R409, R411, R412, R413, R414, R415, R416, R417, R418, R419, R428: 4.7k; R_0805_2012Metric
R425, R426, R490, R491, R492, R495: 10k; R_0805_2012Metric
TH401, TH402, TH403: NXFT15XH103FA2B100; PinHeader_1x02_P2.00mm_Vertical
TP401, TP402, TP403, TP404, TP405, TP406, TP407, TP408, TP409, TP410, TP418, TP419, TP450, TP451, TP452, TP453, TP492, TP493: TestPoint; TestPoint_THTPad_D1.5mm_Drill0.7mm
U401: OwnTech_SPIN; OwnTech_SPINTHT_1
U402: TCAN334GDR; SOIC-8_3.9x4.9mm_P1.27mm
U405: LTC2850xS8; SOIC-8_3.9x4.9mm_P1.27mm
U406: OPA2277; SOIC-8_3.9x4.9mm_P1.27mm
U410: TS5A3357DCUT; VSSOP-8_2.3x2mm_P0.5mm
U490: OPA316; SOT-353_SC-70-5_Handsoldering

Connections:
+3.3V_DGND: C401.1, J403.12, J404.12, R406.2, R407.2, R450.2, U401.36 (+3.3V), U402.3 (VCC)
+5V_DGND: C410.1, C413.1, C420.2, C491.1, J301.1, R409.1, U401.40 (+VIN), U405.8 (VCC), U406.8 (V+), U410.8 (V+), U490.5 (V+)
+6V: J403.10, J404.10
A: J403.3, J404.3, JP403.1 (A), JP408.2 (B), U405.6 (A)
ADC2_IN5: C470.1, R470.1, U401.35 (PC4)
B: J403.4, J404.4, JP409.1 (A), R410.2, U405.7 (B)
BOOT0: U401.58 (PB8)
CAN1_STB: U401.20 (PB4), U402.8 (STB)
CAN_H: J403.1, J404.1, JP401.1 (A), U402.7 (CANH)
CAN_L: J403.2, J404.2, R401.2, R402.1, R404.1, U402.6 (CANL)
DAC2: JP417.1 (A), TP409.1, U401.34 (PA6)
DGND: C401.2, C410.2, C413.2, C420.1, C470.2, C490.2, C491.2, J301.4, J403.8, J404.8, R403.1, R405.1, R411.2, R412.2, R414.1, R425.2, R426.2, R428.1, R494.1, TH401.2, TH402.2, TH403.2, TP405.1, TP406.1, TP407.1, TP408.1, TP410.1, TP419.1, TP451.1, TP453.1, TP493.1, U401.3 (GND), U401.8 (GND), U401.13 (GND), U401.18 (GND), U401.23 (GND), U401.28 (GND), U401.33 (GND), U401.38 (GND), U401.54 (GND), U401.57 (GND), U402.2 (GND), U405.5 (GND), U406.4 (V-), U410.4 (GND), U490.2 (V-)
ENCODER_COS: J301.3, U401.45 (PA4)
ENCODER_SIN: J301.2, U401.43 (PC5)
Earth_Protective: J403.SH, J404.SH
FDCAN2_{RX}: U401.53 (PB5), U402.4 (RXD)
FDCAN2_{TX}: U401.55 (PB6), U402.1 (TXD)
HALL1_A_DGND: U401.7 (PC6)
HALL2_B_DGND: U401.9 (PC7)
HALL3_Z_DGND: U401.49 (PD2)
HRTIM1_SCIN: J403.7, J404.7, JP406.2 (B), JP410.2 (B)
HRTIM_CHA1_DGND: TP403.1, U401.12 (PA8)
HRTIM_CHA2_DGND: TP404.1, U401.14 (PA9)
HRTIM_CHC1_DGND: TP401.1, U401.2 (PB12)
HRTIM_CHC2_DGND: TP402.1, U401.4 (PB13)
HRTIM_CHE1_DGND: TP450.1, U401.10 (PC8)
HRTIM_CHE2_DGND: TP452.1, U401.11 (PC9)
I_{I1Low_sense_DGND}: U401.25 (PC1)
I_{I2Low_sense_DGND}: U401.30 (PA1)
I_{I3Low_sense_DGND}: U401.1 (PB11)
I_{IHigh_sense_DGND}: U401.27 (PC3)
unnamed: C301.1, R494.2, R495.2, U490.3 (-)
unnamed: C411.1, R415.1, R470.2, U406.7
unnamed: C411.2, R415.2, R418.1, U406.6 (-)
unnamed: C412.1, R414.2, R416.1, U406.2 (-)
unnamed: D403.2 (A), U406.1
unnamed: J403.9, R403.2
unnamed: J403.11, R402.2
unnamed: J404.9, R405.2
unnamed: J404.11, R404.2
unnamed: JP401.2 (B), R401.1
unnamed: JP403.2 (B), R410.1
unnamed: JP408.1 (A), R409.2
unnamed: JP409.2 (B), R411.1
unnamed: JP417.2 (B), R413.1
unnamed: R413.2, R417.1, U406.3 (+)
unnamed: R419.1, R428.2, U406.5 (+)
Neutral: C490.1, R490.1, R491.1, R492.1, U490.1 (+)
Neutral_buff: C301.2, R495.1, TP492.1, U401.31 (PB0), U490.4
PB1: JP406.1 (A), U401.37 (PB1)
PB2: JP410.1 (A), U401.42 (PB2)
PB7: JP405.1 (A), U401.56 (PB7)
PC12: JP402.1 (A), U401.19 (PC12)
PC13: JP404.1 (A), U401.22 (PC13)
SHARE+: C412.2, D403.1 (K), J403.5, J404.5, R416.2, R419.2
SHARE-: J403.6, J404.6, R417.2, R418.2
Temp1: R406.1, TH401.1, U410.1
Temp2: R407.1, TH402.1, U410.2
Temp2_Mux: R425.1, U401.21 (PB9), U410.5
Temp3: R450.1, TH403.1, U410.3
Temp3_Mux: R426.1, U401.15 (PA10), U410.6
Temp_x: TP418.1, U401.6 (PB15), U410.7
USART3_DE: R412.1, U401.5 (PB14), U405.2 (~RE), U405.3 (DE)
USART3_RX: U401.17 (PC11), U405.1 (RO)
USART3_TX: U401.16 (PC10), U405.4 (DI)
V_{I1Low_sense_DGND}: R490.2, U401.24 (PC0)
V_{I2Low_sense_DGND}: R491.2, U401.29 (PA0)
V_{I3Low_sense_DGND}: R492.2, U401.44 (PA7)
V_{IHigh_sense_DGND}: U401.26 (PC2)
~STBY1_DGND: JP402.2 (B)
~STBY2_DGND: JP404.2 (B)
~STBY3_DGND: JP405.2 (B)

Notes on the sheet:
Simulation Available https://tinyurl.com/25vbbclf
HW configuration
Neutral = 1/3*(V1+V2+V3)
Max current flowing: 0.16mA@125°C R0 = 10kOhm @T0 = 25°C B = 3450 R = R0 * exp[B(T0-T)/T0*T] Temp expressed in °K
Debugger conflict
RS485 Transceiver
Analog bus
Test points
Virtual neutral
Low pass filter Resistor = 120R Cap = 10nF Cutoff freq = 132 kHz
SPIN Pinout
Hall effect type encoder is placed on PA7, PC6 and PD2 A, B, Z, encoder type is placed on PA7 (A), PC6 (B), and PD2 (Z) which correspond to TIM3 encoder mode. SIN/COS encoder requires a small daugther (tied to J301) board to convert differential signals to single ended. Inputs PC5 (ADC2_IN11) and P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
Communication link encompasses - Analog bus - CAN bus - HRTIM sync - RS485 20Mbps bus
Neutral_buff = 1/3*(V1+V2+V3)*(1+RA/RB)
Current sharing analog bus. Highest voltage is imposing its voltage to the bus Simulation available https://tinyurl.com/2qg7lcok
Temperature sensor
Simulation available: https://tinyurl.com/2262hpg6
Multiplexing temperature signal
Low pass filter Resistor = 120R Cap = 15nF Cutoff freq = 88.5 kHz
Communication RJ45 terminals
Control is pulled down so it doesn't have to be handled by software Send logic 1 on Temp2_Mux to sense Temp 2 Send logic 1 on Temp3_Mux to sense Temp 3
Whole page is in Digital AREA
Debugger conflict : PA13 PA14 PB3 PA2 PA3
CAN Transceiver
Temperature sensor is wired to a flexible temp probe attached to the heatsink Range : -5°C to +125°C
Position hall sensor encoder connector
